MinghaoStark/STM32G431CBU6_Mini_Board/Docs/PINSET.pptx

引脚功能_串行接口

GPIO

USART

SPI

GPIOC13

GPIOB9

GPIOB8

USART3_TX

USART3_RX

I2C1_SDA

I2C1_SCL

I2C

GPIOA0

GPIOA1

GPIOB7

GPIOB6

USART1_RX

USART1_TX

I2C1_SDA

USART2_TX

USART2_RX

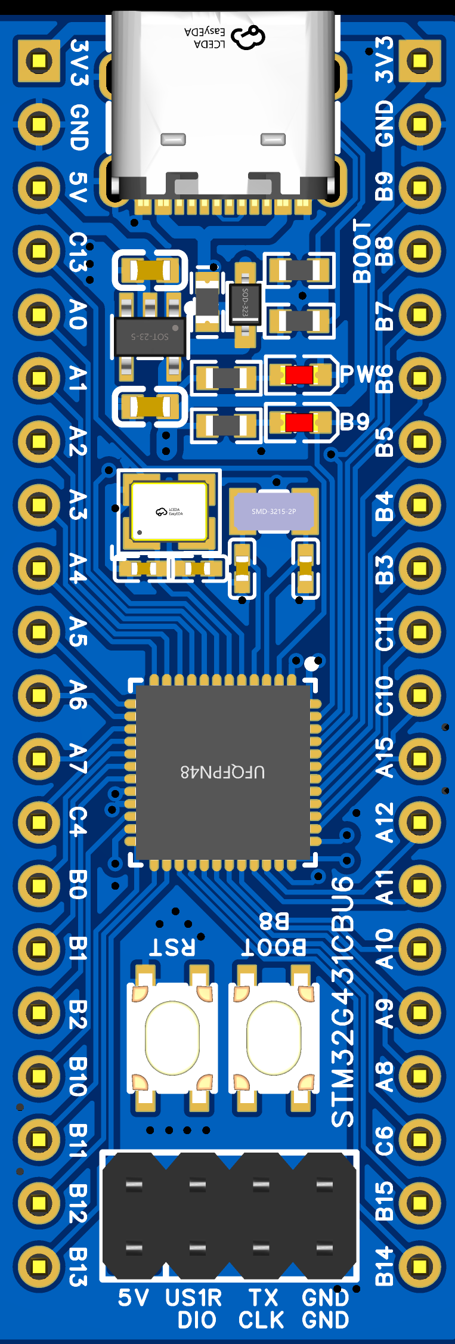
[picture p3: figure]
board_top

GPIOA2

GPIOA3

GPIOB5

GPIOB4

I2C3_SDA

USART2_RX

SPI1_MOSI

SPI1_MISO

SPI3_MOSI

SPI3_MISO

SPI1_SCK

SPI1_MISO

GPIOA4

GPIOA5

GPIOA6

GPIOB3

GPIOC11

GPIOC10

USART2_TX

USART3_RX

USART3_TX

SPI1_SCK

I2C3_SDA

SPI3_SCK

SPI3_SCK

SPI3_MISO

I2C2_SCL

SPI1_MOSI

USART1_TX

GPIOA7

GPIOC4

GPIOA15

GPIOA12

USART2_RX

I2C1_SCL

GPIOB0

GPIOB1

GPIOA11

GPIOA10

SPI2_MOSI

USART1_RX

SPI2_MISO

USART3_TX

GPIOB2

GPIOB10

GPIOA9

GPIOA8

USART1_TX

I2C3_SCL

I2C2_SCL

I2C2_SDA

USART3_RX

SPI2_SCK

GPIOB11

GPIOB12

GPIOB13

GPIOC6

GPIOB15

GPIOB14

SPI2_MOSI

SPI2_MISO

## Slide 2

引脚功能_AD/DA转换

GPIO

USART

SPI

GPIOC13

GPIOB9

GPIOB8

USART3_TX

USART3_RX

I2C1_SDA

I2C1_SCL

I2C

GPIOA0

GPIOA1

GPIOB7

GPIOB6

USART1_RX

USART1_TX

I2C1_SDA

USART2_TX

USART2_RX

GPIOA2

GPIOA3

GPIOB5

GPIOB4

I2C3_SDA

USART2_RX

SPI1_MOSI

SPI1_MISO

SPI3_MOSI

SPI3_MISO

SPI1_SCK

SPI1_MISO

GPIOA4

GPIOA5

GPIOA6

GPIOB3

GPIOC11

GPIOC10

USART2_TX

USART3_RX

USART3_TX

SPI1_SCK

I2C3_SDA

SPI3_SCK

SPI3_SCK

SPI3_MISO

I2C2_SCL

SPI1_MOSI

USART1_TX

GPIOA7

GPIOC4

GPIOA15

GPIOA12

USART2_RX

I2C1_SCL

GPIOB0

GPIOB1

GPIOA11

GPIOA10

SPI2_MOSI

USART1_RX

SPI2_MISO

USART3_TX

GPIOB2

GPIOB10

GPIOA9

GPIOA8

USART1_TX

I2C3_SCL

I2C2_SCL

I2C2_SDA

USART3_RX

SPI2_SCK

GPIOB11

GPIOB12

GPIOB13

GPIOC6

GPIOB15

GPIOB14

SPI2_MOSI

SPI2_MISO

## Slide 3

USB_C接口

自恢复保险丝

肖特基二极管

LDO

POWER_LED

8MHz晶振

USER_LED

32.768KHz晶振

G431CBU6

RESET按键

BOOT按键
