MinghaoStark/STM32G431CBU6_Mini_Board/Hardware/BOM_v1.0_RT9013-33GB_G431CBU6最小系统板_2024-07-07.xlsx

No. | Quantity | Comment | Designator | Footprint | Value | Manufacturer Part | Manufacturer | Supplier Part | Supplier
1 | 2 | 1uF | C34,C35 | C0603 | 1uF
2 | 6 | 100nF | C68,C69,C70,C71,C72,C73 | C0603 | 100nF
3 | 4 | 22pF | C74,C75,C76,C77 | C0402 | 22pF
4 | 1 | 1N5819WS | D2 | SOD-323_L1.8-W1.3-LS2.5-RD |  | 1N5819WS | Hottech(合科泰) | C191023 | LCSC
5 | 1 | BSMD0603-050-6V | F1 | F0603 |  | BSMD0603-050-6V | BHFUSE(佰宏) | C883095 | LCSC
6 | 1 | PZ254V-12-8P | H1 | HDR-TH_8P-P2.54-V-M-R2-C4-S2.54 |  | PZ254V-12-8P | XFCN(兴飞) | C492421 | LCSC
7 | 2 | X6511WV-20H-C60D30 | H2,H3 | HDR-TH_20P-P2.54-V-M |  | X6511WV-20H-C60D30 | XKB Connection(中国星坤) | C725952 | LCSC
8 | 2 | LED_0603-R | LED1,LED2 | LED_0603
9 | 3 | 10K | R43,R46,R49 | R0603 | 10K
10 | 1 | 100K | R44 | R0603 | 100K
11 | 2 | 5.1K | R47,R48 | R0603 | 5.1K
12 | 2 | K2-1808SN-A3SW-01 | SW1,SW2 | SW-SMD_4P-L4.2-W3.3-P2.15-LS5.1 |  | K2-1808SN-A3SW-01 | 韩国韩荣 | C2690012 | LCSC
13 | 1 | STM32G431CBU6 | U26 | UFQFPN-48_L7.0-W7.0-P0.50-BL-EP |  | STM32G431CBU6 | ST(意法半导体) | C529356 | LCSC
14 | 1 | TPRT9013-33GB | U28 | SOT-23-5_L3.0-W1.7-P0.95-LS2.8-BL |  | TPRT9013-33GB | TECH PUBLIC(台舟) | C587158 | LCSC
15 | 1 | KH-TYPE-C-16P | USB2 | USB-C-SMD_KH-TYPE-C-16P |  | KH-TYPE-C-16P | kinghelm(金航标) | C709357 | LCSC
16 | 1 | 25MHz | X1 | OSC-SMD_4P-L3.2-W2.5-BL | 25MHz | X322525MOB4SI | YXC(扬兴晶振) | C9006 | LCSC
17 | 1 | 32.768kHz | X2 | FC-135R_L3.2-W1.5 | 32.768kHz | Q13FC13500004 | EPSON(爱普生) | C32346 | LCSC
