MinghaoStark/STM32G431CBU6_Mini_Board/Hardware/SCH_G431CBU6最小系统板_2024-07-07.pdf

# 按键、LED 电源

排针

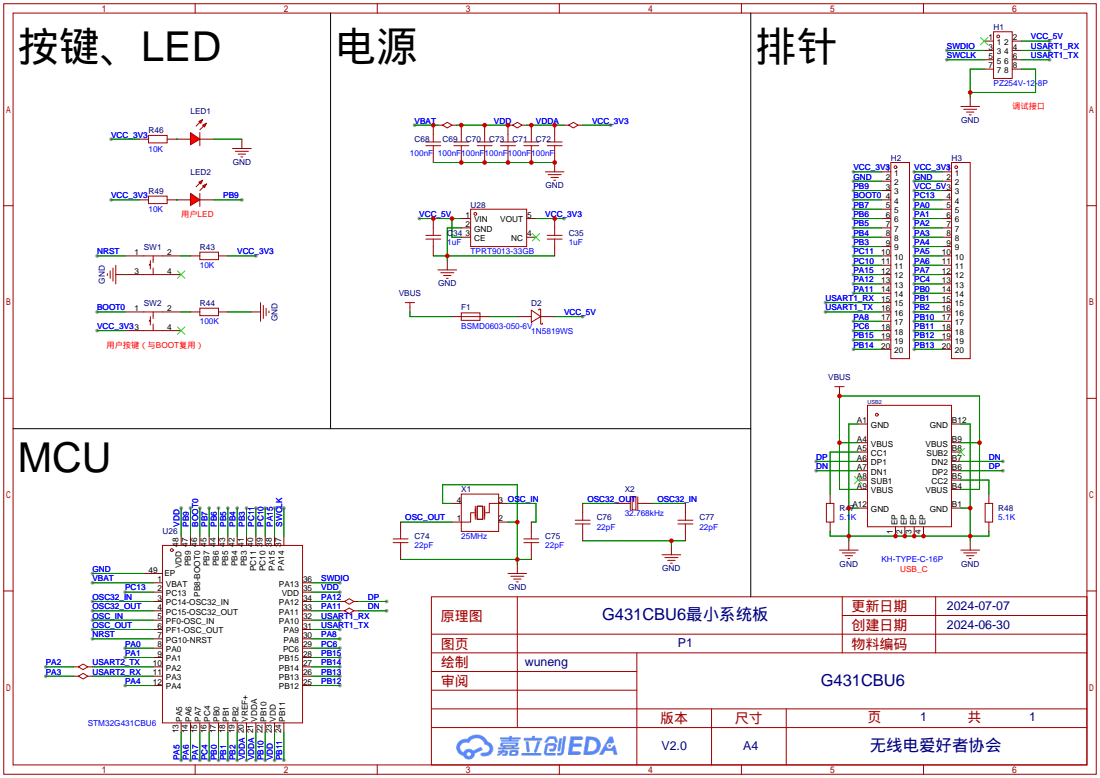
[picture p4: page 1]

PB12 25 PB¹¹ 24 VDD 23 PB¹⁰ 22 VDDA 21 VREF+ 20 PB² 19 PB¹ 18 PB⁰ 17 PC⁴ 16 PA⁷ 15 PA⁶ 14 PA⁵ 13
