MinghaoStark/STM32G431CBU6_Mini_Board/(list of files, drawings)

Other design files:
Hardware/G431CBU6最小系统板_v2.0_RT9013-33GB_2024-07-07.epro
