MinghaoStark/STM32G431CBU6_Mini_Board/Software/G431CB_BOOTKEY/Core/Src/main.c

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
/* Includes ------------------------------------------------------------------*/
#include "main.h"
#include "tim.h"
#include "usart.h"
#include "gpio.h"

/* USER CODE BEGIN Includes */

#include "interrupt.h"

/* USER CODE END Includes */


void SystemClock_Config(void);
/* USER CODE BEGIN 0 */

extern struct keys key[];

/* USER CODE END 0 */

/**
  * @brief  The application entry point.
  * @retval int
  */
int main(void)
{

  /* MCU Configuration--------------------------------------------------------*/

  /* Reset of all peripherals, Initializes the Flash interface and the Systick. */
  HAL_Init();

  /* Configure the system clock */
  SystemClock_Config();

  /* Initialize all configured peripherals */
  MX_GPIO_Init();
  MX_TIM15_Init();
  MX_USART1_UART_Init();
  /* USER CODE BEGIN 2 */
	
HAL_TIM_Base_Start_IT (&htim15 );
printf("interrupt ok\r\n");
  /* USER CODE END 2 */

  /* Infinite loop */
  /* USER CODE BEGIN WHILE */
  while (1)
  {
		//printf("keys%d ok\r\n",key[0].s_flag);
		//printf("keyl%d ok\r\n",key[0].l_flag);
		if(key[0].s_flag ==1)
		{
			printf("key0s down\r\n");
			key[0].s_flag =0;
		}
		if(key[0].l_flag ==1)
		{
			printf("key0l down\r\n");
			key[0].l_flag =0;
		}
		HAL_Delay(10);
    /* USER CODE END WHILE */

    /* USER CODE BEGIN 3 */
  }
  /* USER CODE END 3 */
}

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
/* USER CODE BEGIN 4 */

int fputc(int ch, FILE *f)
 
{
 
  HAL_UART_Transmit(&huart1, (uint8_t *)&ch, 1, 0xffff);
 
  return ch;
 
}


/* USER CODE END 4 */
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
