MinghaoStark/STM32G431CBU6_Mini_Board/Software/G431CB_BOOTKEY/G431CB_BOOTKEY.ioc

Mcu.UserName=STM32G431CBUx
PA10.Signal=USART1_RX
PA13.Signal=SYS_JTMS-SWDIO
PA14.Signal=SYS_JTCK-SWCLK
PA9.Signal=USART1_TX
PB8-BOOT0.Signal=GPIO_Input
PC14-OSC32_IN.Signal=RCC_OSC32_IN
PC15-OSC32_OUT.Signal=RCC_OSC32_OUT
PF0-OSC_IN.Signal=RCC_OSC_IN
PF1-OSC_OUT.Signal=RCC_OSC_OUT
