MinghaoStark/STM32G431CBU6_Mini_Board/(notices)

Notices in the files:
Software/G431CB_BOOTKEY/Core/Src/main.c:
Copyright (c) 2024 STMicroelectronics.
All rights reserved.
This software is licensed under terms that can be found in the LICENSE file
